SignalK/ArduinoTC/_D7K7246.jpg

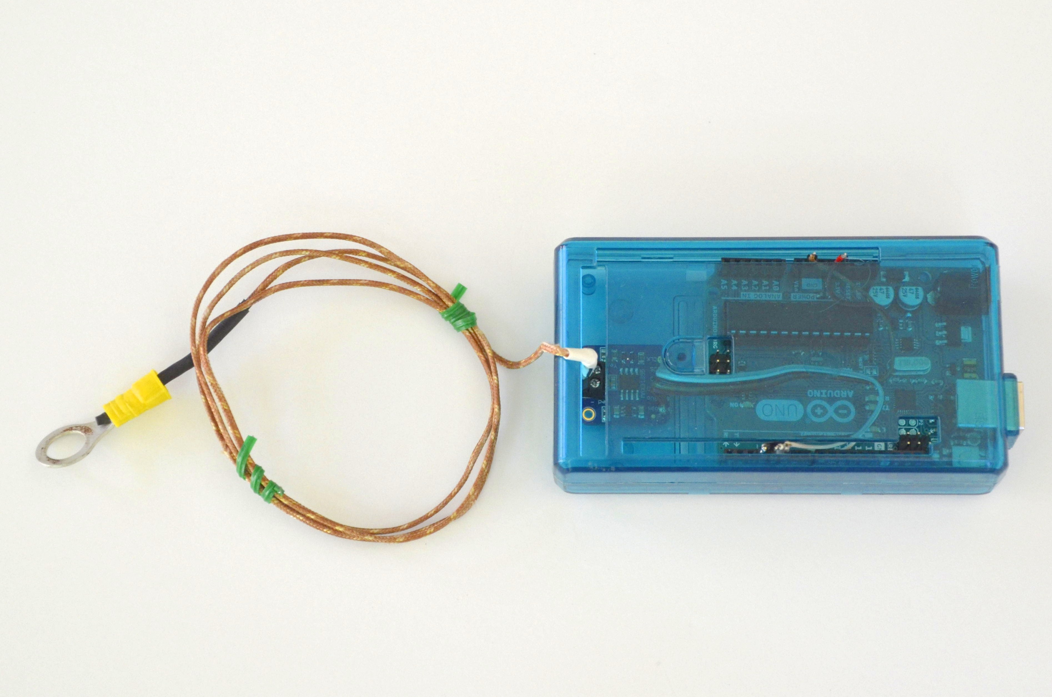
_D7K7246.jpg
