SignalK/ArduinoTC/_D7K7247.jpg

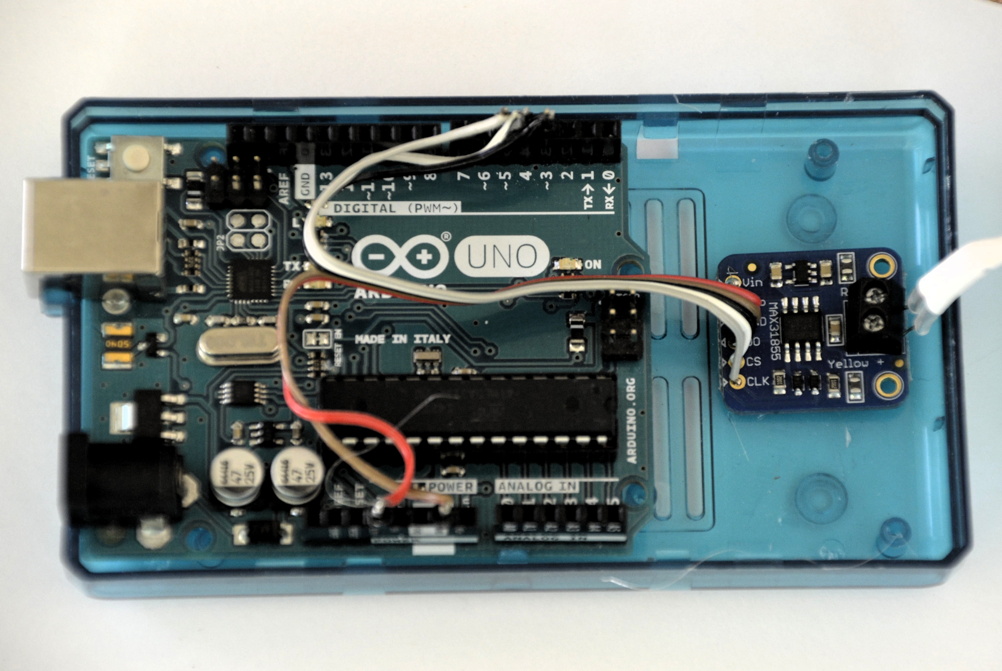
_D7K7247.jpg
