SignalK/ArduinoTC/README.md

# ArduinoTC
An Arduino based themocouple temperature monitor.
This project provides the hardware description and software for an Arduino based thermocouple temperature monitor. 
It is intended to provide a way to measure and display the vessel engine temperature.
